db-electronics/Universal-Mega-Dumper/(threads)

Thread 1 (2018-01-16):

Reading the MX28Fx00 flash id only returns the manufacturer ID, not the device ID

db-electronics, 2018-01-16:
After the read ID command is issued, reads from addresses 0x00 and 0x01 both return the 0xC2. 0xC2 should only be returned when reading address 0x00, 0xD6/0x58 should be returned from address 0x01.
