db-electronics/Universal-Mega-Dumper/Schematic/TeensyDumper_1.1.pdf

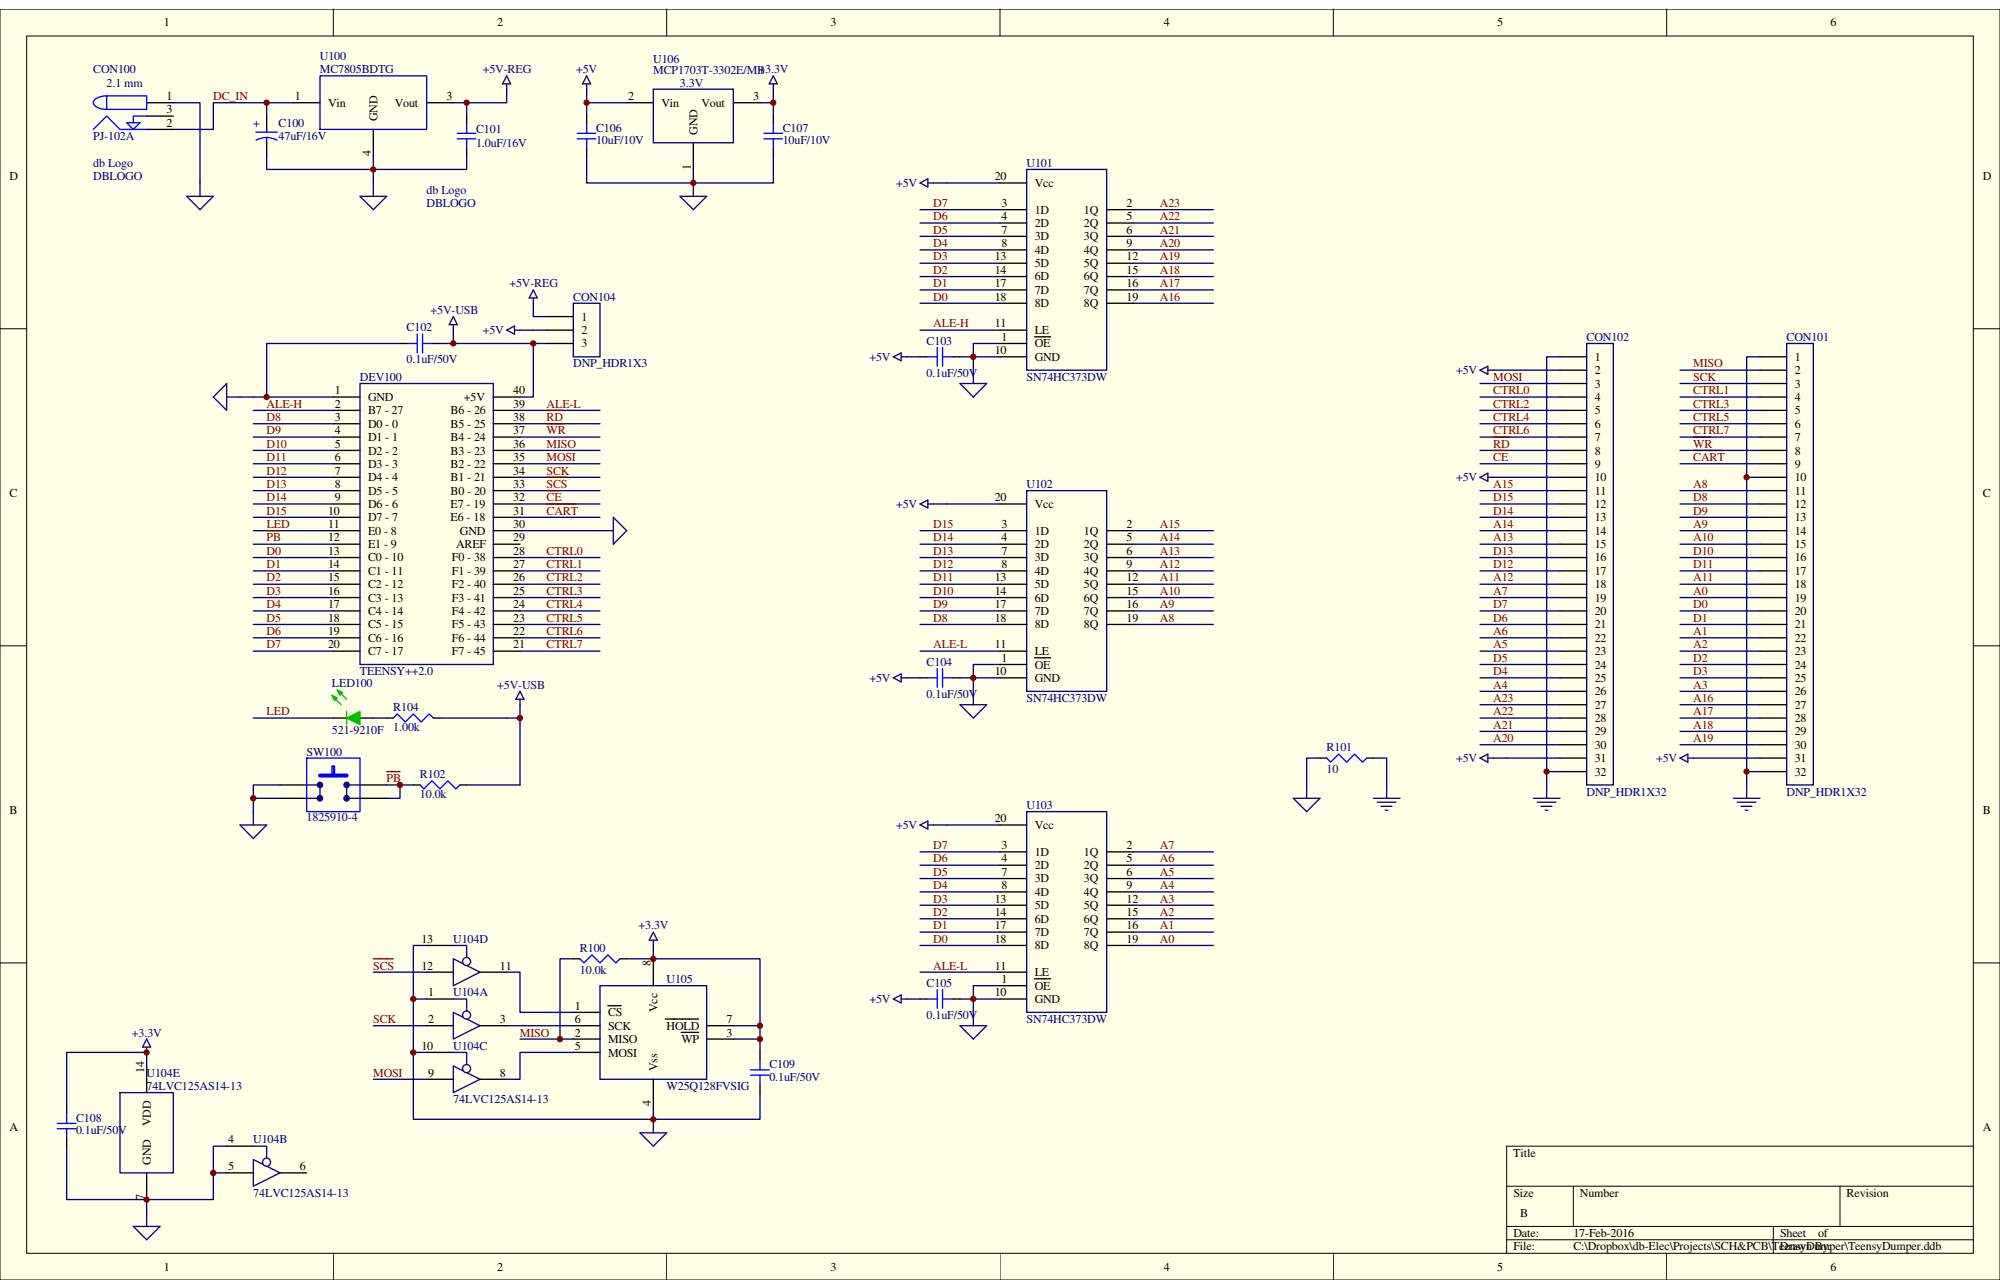
[picture p1: page 1]
