db-electronics/Universal-Mega-Dumper/UMDv1-pio/src/generic.cpp

#include "generic.h"

void GenericCart::calcChecksum()
{
}

void GenericCart::enableSram(uint8_t param)
{
}

void GenericCart::disableSram(uint8_t param)
{
}

uint32_t GenericCart::getRomSize()
{
    return 0;
}
