db-electronics/Universal-Mega-Dumper/(commit log)

2016-04-21 new board rev 1.1
2016-08-10 added writeByteCMD - not working
    [TestDumper.ino, dbDumper.cpp, dbDumper.h]
2016-08-12 more work on Coleco carts, not working yet
    [dbDumper.cpp, dbDumper.h]
2016-11-23 changed flash-thunder LED on time
2017-01-19 erase working, partially working burn
    [TestDumper.ino, dbDumper.cpp]
2017-03-24 first dump and burn for TG16
    [dbDumper.cpp, dbDumper.h]
2017-05-10 burn from serial flash working
    [TestDumper.ino, dbDumper.cpp, dbDumper.h]
2017-07-27 fixed ambiguities between writeByte uint16_t and uint32_t
    [TestDumper.ino, dbDumper.cpp, dbDumper.h]
2017-07-28 can read SMS carts accross slot boundaries
2017-07-28 unstable reads from SMS carts, maybe power related
    [TestDumper.ino, dbDumper.cpp, dbDumper.h]
2017-12-22 improved SMS slot reading
2018-01-08 can erase and burn SMS carts, not sure about stability of first 1KB
    [TestDumper.ino, dbDumper.cpp, dbDumper.h]
2018-01-09 consistent SMS read and write after pullup resistor fix
    [TestDumper.ino, dbDumper.cpp, dbDumper.h]
2018-01-15 refactoring the python interface - currently broken
    [classumd.py, umd.py]
2018-01-15 consolidating more switches into single --rd command
2018-01-15 most major commands refactored into rd/wr/clr - still have bugs on getid
    [classumd.py, umd.py]
2018-01-23 fixed tg setmode bug
    [classumd.py, umd.py]
2018-01-26 stupid typo in last commit, fixed
    [romopsumd.py]
2018-03-08 fixed dual chip erase for Genesis boards
    [umd.py]
2018-03-14 Suggest the default Arduino directory by default.
2018-03-14 fixing checksum code, generalizing
    [classumd.py]
2018-03-21 added 1.1 schematic
2018-03-23 - Added tentative latch functions for bank switching on Genesis/MD - Can dump MD Super Street Fighter II with one wrong byte, need to find BUG
    [umd.h]
2018-03-23 - Adds extra missing parameters for save to file
    [hardware.py]
2018-03-26 - Can dump the "SFII mapper" on PC Engine, detected when asking for more than 0x100000 bytes, but it works from any offset. - Maybe platform specific stuff should be moved to it's own class/function.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
2018-04-08 - Reduced unnecesary Bank switching on SMS - Added Hex ROM size display to SMS Header
2018-05-15 optimized burning speeds, improved ID reads
    [hardware.py, umd.h]
2018-06-09 Fix compilation of umdbase.cpp
    [umdbase.cpp]
2018-06-09 Ability to force the port used of the UMD device
2018-06-11 Fix tiny bug in umd.py and added new multi.py wrapper script
    [multi.py, umd.py]
2018-07-14 Work around Windows codepage issue with python print function.
    [umd.py]
2018-08-03 Add DAT-file matching and file renaming/copying, fix SMS header bug, fix minor bug when checksumming an underdumped genesis rom
    [genesis.py, hardware.py, umd.py]
2018-08-03 Revert the reduced SMS bank switching. 8Mb rom reads are broken, and time savings seem to be negligible
2018-08-07 fixed f-string syntax for Python 3.5 in --dat arg
    [umd.py]
2018-08-09 Add rom size read command, change default size arg to 0, attempt to read based on header rom size if size unspecified or 0. Fix GUI bug
    [gui.py, hardware.py, poly-interface.ino, umd.py]
2018-08-09 Run the main pin setup / initialization only once, moved to static initialize function in umdbase from constructor
2018-08-09 Fix regression where 'mode = undefined' wasn't sent back
    [poly-interface.ino]
2018-08-10 Change file layout to better organize the teensy code
2018-08-10 Fix sorting of modes in GUI
    [gui.py]
2018-08-10 Remove progress bar prints from GUI output.
2018-08-10 Fix SMS writeByte override. writes need to be tested
    [sms.cpp, sms.h]
2018-10-12 retesting in master, issues here
    [Sketch.ino, genesis.py, hardware.py, sms.cpp, sms.py, snes.py, umd.py]
2019-05-09 removed overloads for latch_address, Arduino compiler doesn't seem to always play well with these
    [Sketch.ino, genesis.cpp, hardware.py, sms.cpp, sms.h, umdbase.cpp, umdbase.h]
2019-06-11 modified read/write timing, seems to improve slightly errors seen on s29gl series chips... more research required
    [Sketch.ino, genesis.cpp, umdbase.cpp]
2019-06-28 sped up writeWord - shaved 100s off of a 4MB burn
    [umdbase.cpp]
2020-12-16 improved Genesis burning speed, added 'auto' rom burning from pushbutton
    [genesis.cpp, main.cpp, umdv1.cpp, umdv1.h]
2020-12-16 fixed mode on PB autoload, SMS checksum seems good too, need to test cartridge on real hardware now
    [genesis.cpp, main.cpp, sms.cpp, sms.py, umd.py, umdv1.cpp, umdv1.h]
2021-06-02 fixed sram writes to Genesis
    [genesis.cpp]
2021-11-20 added missing pio project files
    [umdbase.cpp, umdbase.h]
